mat-bond/BMI-EMG-HW/BioAmp/BioAmp-EXG-Pill.step

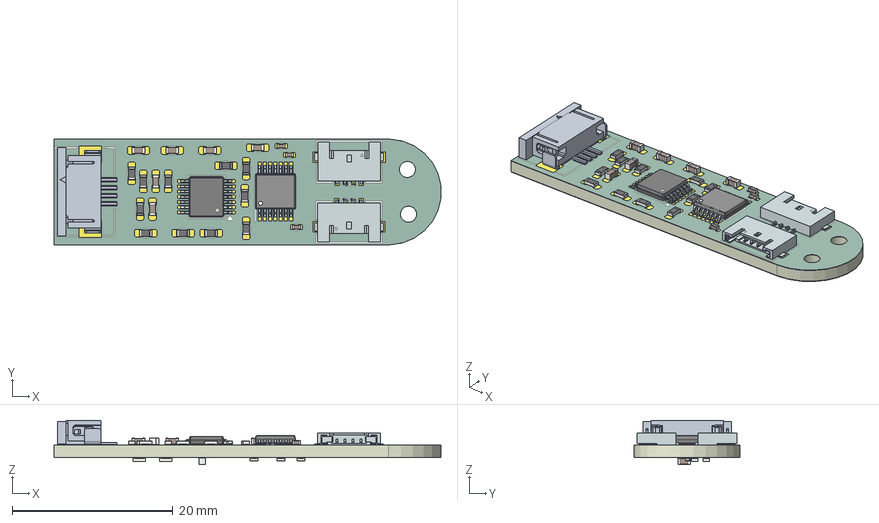
[picture p1: CAD file, 2026-10-02]
BioAmp/BioAmp-EXG-Pill.step
48.2 x 13.2 x 5.49 mm
R_0603_1608Metric x 15
C_0603_1608Metric x 7
TSSOP-14_4.4x5mm_P0.65mm
MAX5484EUD+
C_0402_1005Metric x 3
R_0402_1005Metric x 3
BioAmp-EXG-Pill-unsaved-export-KkKg1b_copper
BioAmp-EXG-Pill-unsaved-export-KkKg1b_silkscreen x 2
BioAmp-EXG-Pill-unsaved-export-KkKg1b_soldermask x 2
BioAmp-EXG-Pill-unsaved-export-KkKg1b_PCB
