mat-bond/BMI-EMG-HW/BioAmp/BioAmp-EXG-Pill.kicad_pcb

## KiCad design BioAmp/BioAmp-EXG-Pill.kicad_pcb (2026-10-08)

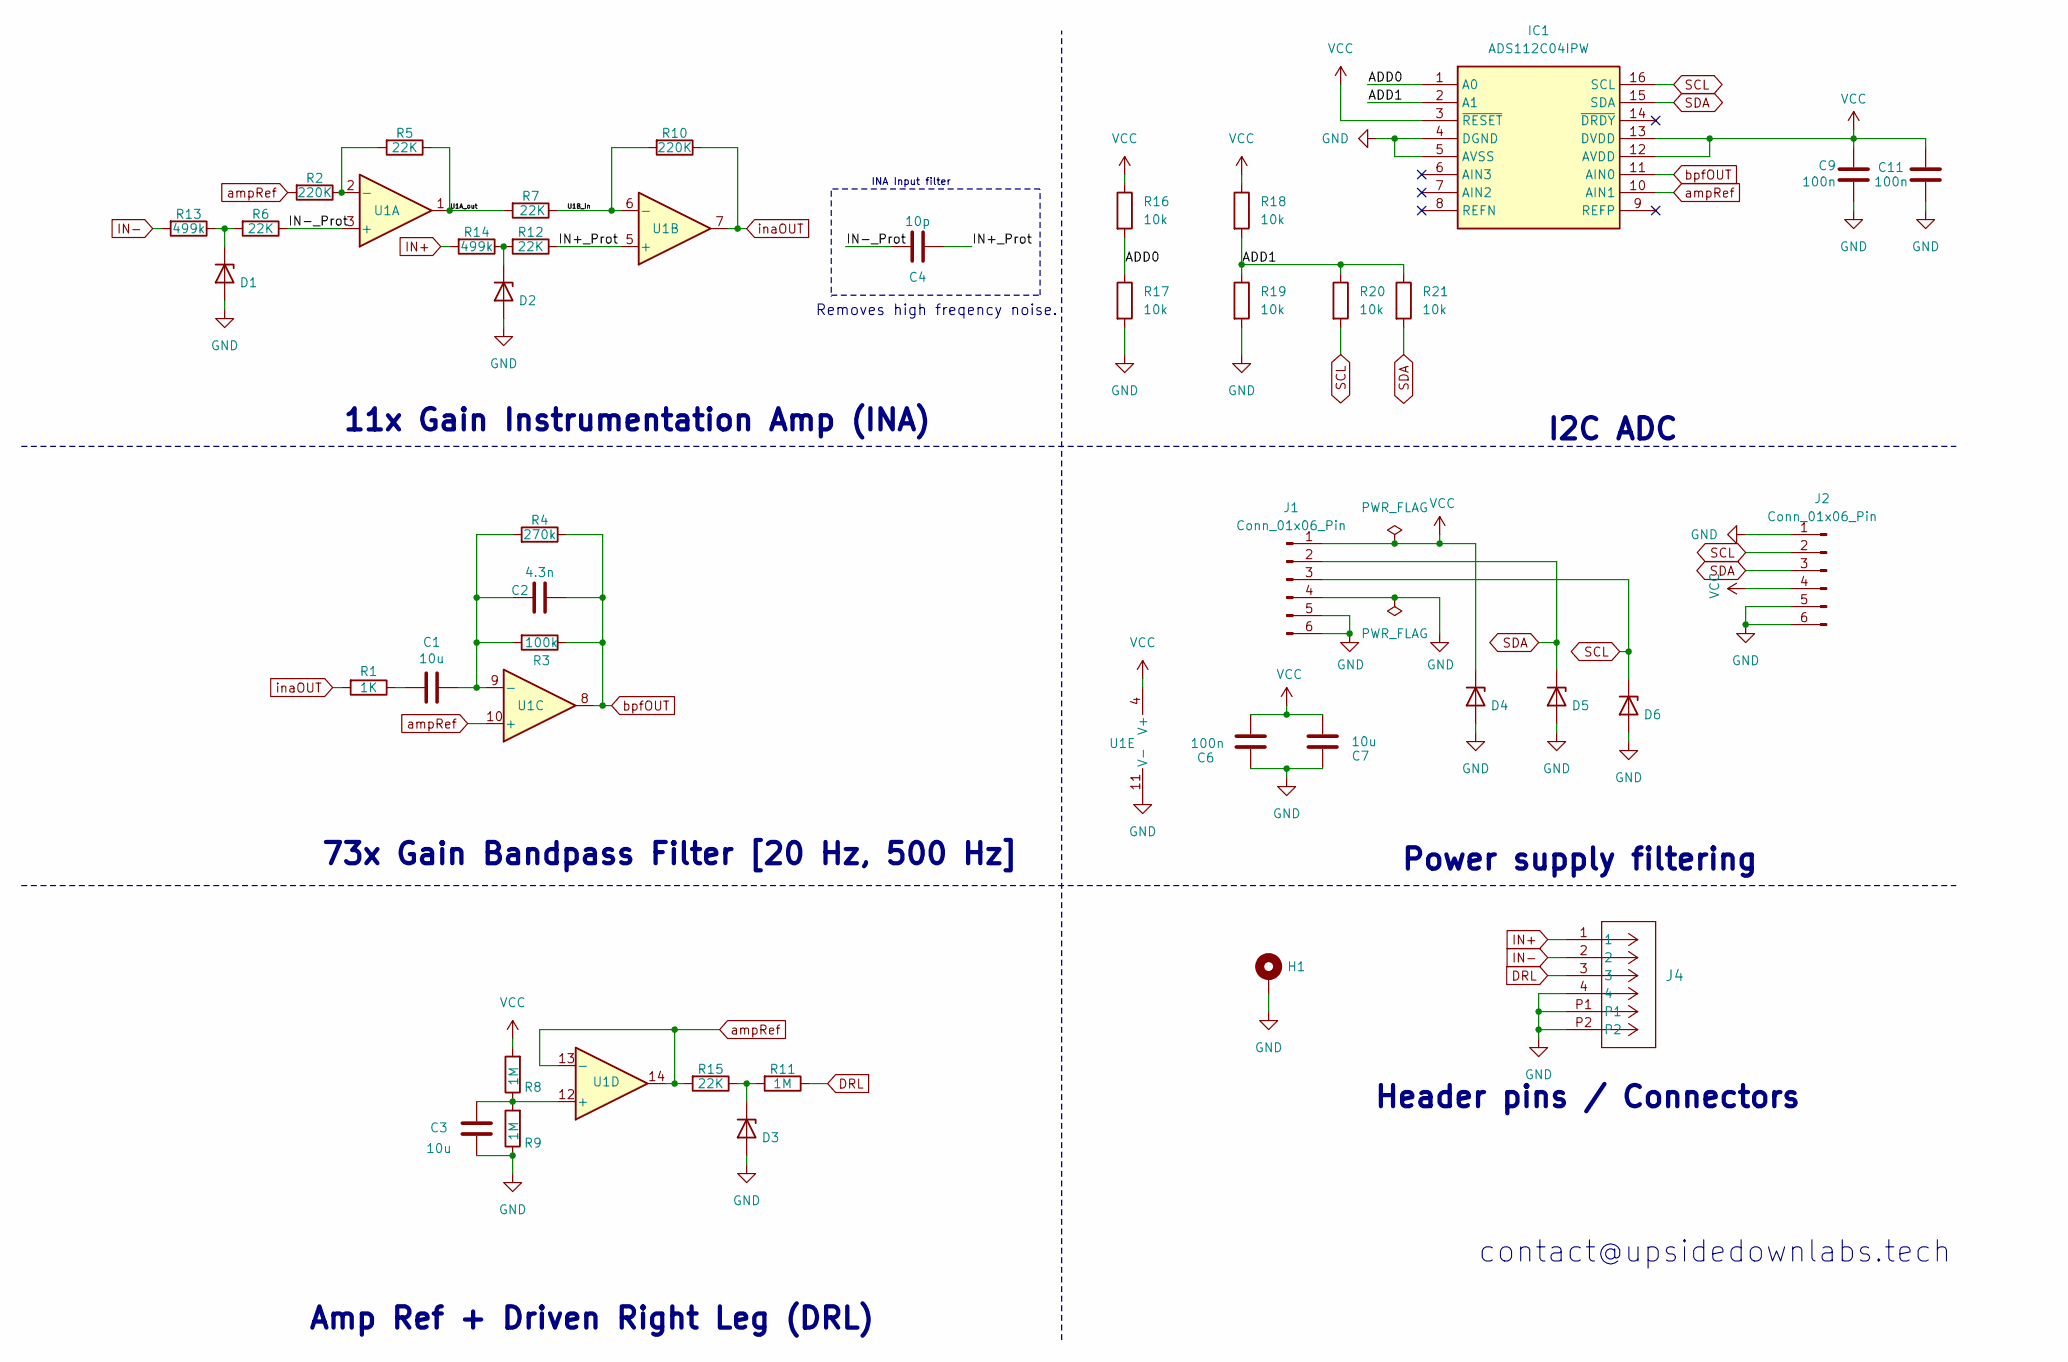
[picture p2: schematic BioAmp-EXG-Pill.kicad_sch, BioAmp EXG Pill]

Parts:
C1, C3, C7: 10u; C_0603_1608Metric_Pad1.08x0.95mm_HandSolder
C2: 4.3n; C_0603_1608Metric_Pad1.08x0.95mm_HandSolder
C4: 10p; C_0603_1608Metric_Pad1.08x0.95mm_HandSolder
C6: 100n; C_0603_1608Metric_Pad1.08x0.95mm_HandSolder
C9, C11: 100n; C_0402_1005Metric
D1, D2, D3, D4, D5, D6: ESD441DPLR; D_0201_0603Metric
H1: MountingHole_Pad; MountingHole_2.5mm_Pad
IC1: ADS112C04IPW; SOP65P640X120-16N; Mouser Part Number 595-ADS112C04IPW
J1, J2: Conn_01x06_Pin; CONN_5037630000-SD_04_MOL
J4: 522710469; CON_522710469_MOL
R1: 1K; R_0603_1608Metric_Pad0.98x0.95mm_HandSolder
R2, R10: 220K; R_0603_1608Metric_Pad0.98x0.95mm_HandSolder
R3: 100k; R_0603_1608Metric_Pad0.98x0.95mm_HandSolder
R4: 270k; R_0603_1608Metric_Pad0.98x0.95mm_HandSolder
R5, R6, R7, R12, R15: 22K; R_0603_1608Metric_Pad0.98x0.95mm_HandSolder
R8, R9, R11: 1M; R_0603_1608Metric_Pad0.98x0.95mm_HandSolder
R13, R14: 499k; R_0603_1608Metric_Pad0.98x0.95mm_HandSolder
R16, R17, R18, R19, R20, R21: 10k; R_0603_1608Metric_Pad0.98x0.95mm_HandSolder
U1: TL074HIPWR; TSSOP-14_4.4x5mm_P0.65mm

Connections:
/ADD0: IC1.1 (A0), R16.2, R17.1
/ADD1: IC1.2 (A1), R18.2, R19.1, R20.1, R21.1
/IN+_Prot: C4.1, R12.1, U1.5 (+)
/IN-_Prot: C4.2, R6.1, U1.3 (+)
/U1A_out: R5.1, R7.2, U1.1
/U1B_in: R7.1, R10.2, U1.6 (-)
DRL: J4.3, R11.1
GND: C3.2, C6.1, C7.1, C9.1, C11.1, D1.2 (A), D2.2 (A), D3.2 (A), D4.2 (A), D5.2 (A), D6.2 (A), H1.1 (1_1), IC1.4 (DGND), IC1.5 (AVSS), J1.4, J1.5, J1.6, J2.1, J2.5, J2.6, J4.4, J4.P1, J4.P2, R9.1, R17.2, R19.2, U1.11 (V-)
IN+: J4.1, R14.2
IN-: J4.2, R13.2
unnamed: C1.2, R1.1
unnamed: D1.1 (K), R6.2, R13.1
unnamed: D2.1 (K), R12.2, R14.1
unnamed: D3.1 (K), R11.2, R15.1
unnamed: R2.1, R5.2, U1.2 (-)
unnamed: C1.1, C2.2, R3.2, R4.2, U1.9 (-)
unnamed: C3.1, R8.1, R9.2, U1.12 (+)
SCL: D6.1 (K), IC1.16 (SCL), J1.3, J2.2, R20.2
SDA: D5.1 (K), IC1.15 (SDA), J1.2, J2.3, R21.2
VCC: C6.2, C7.2, C9.2, C11.2, D4.1 (K), IC1.3 (~RESET), IC1.12 (AVDD), IC1.13 (DVDD), J1.1, J2.4, R8.2, R16.1, R18.1, U1.4 (V+)
ampRef: IC1.10 (AIN1), R2.2, R15.2, U1.10 (+), U1.13 (-), U1.14
bpfOUT: C2.1, IC1.11 (AIN0), R3.1, R4.1, U1.8
inaOUT: R1.2, R10.1, U1.7

Notes on the sheet:
contact@upsidedownlabs.tech
73x Gain Bandpass Filter [20 Hz, 500 Hz]
Header pins / Connectors
11x Gain Instrumentation Amp (INA)
Power supply filtering
Amp Ref + Driven Right Leg (DRL)
Removes high freqency noise.
I2C ADC
INA Input filter

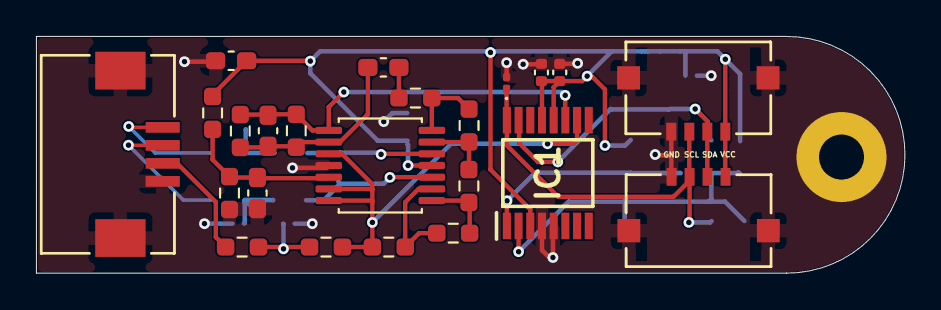
[picture p3: board BioAmp-EXG-Pill.kicad_pcb from above]

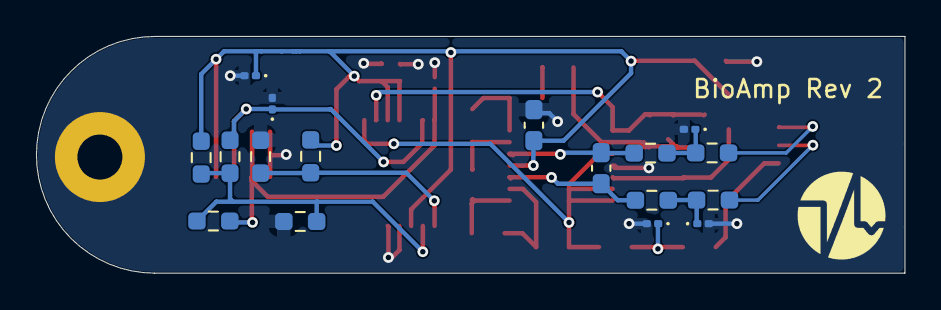
[picture p4: board BioAmp-EXG-Pill.kicad_pcb from below]

Board: 4 copper layers, 48.2 x 13.2 mm, 41 parts (17 on the bottom side), 23 nets.
