mat-bond/BMI-EMG-HW/(commit log)

2026-09-27 Changed bpf gain comment to x180 and added a .gitignore.
    [BioAmp-EXG-Pill.kicad_sch]
2026-09-27 Changed DRL R11 resistor to 1MegaOhm after improvement in signal quality after soldering one on.
    [BioAmp-EXG-Pill.kicad_sch]
2026-09-27 Added Do Not Place marking on C4.
    [BioAmp-EXG-Pill.kicad_sch]
2026-09-28 Changed bandpass gain to x73 and cutoff frequencies to 20 Hz and 500 Hz.
    [BioAmp-EXG-Pill.kicad_pcb, BioAmp-EXG-Pill.kicad_sch]
2026-09-28 Changed C4 to 10pF to increase impedance.
    [BioAmp-EXG-Pill.kicad_sch]
2026-09-28 Added TVS diodes
    [BioAmp-EXG-Pill.kicad_sch]
2026-09-28 Added series resistor after ESD protection at opamp input, 2.2kohm
    [BioAmp-EXG-Pill.kicad_sch]
2026-09-29 Added new ADC and cleaned up ESD protection
    [BioAmp-EXG-Pill.kicad_pcb, BioAmp-EXG-Pill.kicad_sch]
2026-09-29 Fixed ESD protection on J1 (connections were on the wrong side).
    [BioAmp-EXG-Pill.kicad_sch]
2026-09-29 Added series resitors on all electrode connection pins for current limiting
    [BioAmp-EXG-Pill.kicad_pcb, BioAmp-EXG-Pill.kicad_sch]
2026-09-30 Changed electrode resistances to one 1M
    [BioAmp-EXG-Pill.kicad_sch]
2026-09-30 Changed TVS diodes to have lower clamping voltage and added series resitors after protected nodes on opamp
    [BioAmp-EXG-Pill.kicad_pcb, BioAmp-EXG-Pill.kicad_sch]
2026-09-30 Changed IN+/IN- resistors to 500k to reduce noise. Refactored wiring that was off grid
    [BioAmp-EXG-Pill.kicad_sch]
2026-09-30 Added footprints and modesl
    [MAX1169BEUD+.stp]
2026-10-01 Changed C12 to 10uF as per ADC datasheet recommendation
    [BioAmp-EXG-Pill.kicad_sch]
2026-10-01 Removed licensed models
    [MAX1169BEUD+.stp]
2026-10-01 Added ESD diode footprints
    [BioAmp-EXG-Pill.kicad_pcb, BioAmp-EXG-Pill.kicad_sch]
2026-10-01 Exposed J1 4th pin to add a do-not-connect
    [BioAmp-EXG-Pill.kicad_sch]
2026-10-01 Added models and footprints
    [BioAmp-EXG-Pill.kicad_pcb, MAX1169BEUD+.stp]
2026-10-01 Updated FPC connector symbol and footprint
    [BioAmp-EXG-Pill.kicad_pcb, BioAmp-EXG-Pill.kicad_sch]
2026-10-01 Added board constraints
    [BioAmp-EXG-Pill.kicad_pcb, BioAmp-EXG-Pill.kicad_sch]
2026-10-02 Did component placement
    [BioAmp-EXG-Pill.kicad_pcb, BioAmp-EXG-Pill.kicad_sch]
2026-10-02 Added rounded edge with mounting hole
    [BioAmp-EXG-Pill.kicad_pcb, BioAmp-EXG-Pill.kicad_sch]
2026-10-02 Changed I2C connectors, added mounting holes and roundes edge
    [5037630491.stp, 522710469.stp, BioAmp-EXG-Pill.kicad_pcb, BioAmp-EXG-Pill.kicad_sch, BioAmp-EXG-Pill.step]
2026-10-03 Save BioAmp layout before splitting analog and digital grounds
    [BioAmp-EXG-Pill.kicad_pcb, BioAmp-EXG-Pill.kicad_sch]
2026-10-03 Separated analog and digital grounds in schematic
    [BioAmp-EXG-Pill.kicad_sch]
2026-10-03 Finished first layout with separated analog and digital grounds
    [BioAmp-EXG-Pill.kicad_pcb, BioAmp-EXG-Pill.kicad_sch]
2026-10-03 Changed to one mountign hole, improved TVS routing on SCL and SDA
    [BioAmp-EXG-Pill.kicad_pcb, BioAmp-EXG-Pill.kicad_sch]
2026-10-03 Moved C6 decoupling capacitor closer to opamp
    [BioAmp-EXG-Pill.kicad_pcb]
2026-10-03 Moved GND/GNDA tie up and placed vias closer to it.
    [BioAmp-EXG-Pill.kicad_pcb]
2026-10-03 Added silkscreen comments
    [BioAmp-EXG-Pill.kicad_pcb]
2026-10-04 Finished BOM
    [BioAmp-EXG-Pill.csv, BioAmp-EXG-Pill.kicad_pcb, BioAmp-EXG-Pill.kicad_sch]
2026-10-04 Moved R18 to bottom layer to have more space for connector mate
    [BioAmp-EXG-Pill.kicad_pcb, BioAmp-EXG-Pill.kicad_sch]
2026-10-04 Revert to one GND
    [BioAmp-EXG-Pill.kicad_pcb, BioAmp-EXG-Pill.kicad_sch]
2026-10-04 Changed copper pours to never add islands
    [BioAmp-EXG-Pill.kicad_pcb]
2026-10-06 Stopped tracking of footprints
    [5037630491.stp, 522710469.stp, BioAmp-EXG-Pill.csv, BioAmp-EXG-Pill.kicad_pcb, MAX1169BEUD+.stp]
2026-10-07 Changed schematics to new ADC ADS
    [BioAmp-EXG-Pill.kicad_pcb, BioAmp-EXG-Pill.kicad_sch]
2026-10-07 Added footprints
    [5037630491.stp, 522710469.stp, ADS112C04IPW.SchLib, ADS112C04IPW.stp, EDI2CAP.CFG, MAX1169BEUD+.stp, SOP65P640X120-16N.PcbLib, chips.prt]
2026-10-07 Finished layout with new ADC - ADS
    [BioAmp-EXG-Pill.kicad_pcb, BioAmp-EXG-Pill.kicad_sch]
2026-10-07 Changed position of TVS on SCL
    [BioAmp-EXG-Pill.kicad_pcb]
2026-10-07 Added via to GND pins on ADC
    [BioAmp-EXG-Pill.kicad_pcb]
2026-10-07 Moved SDA connection
    [BioAmp-EXG-Pill.kicad_pcb]
2026-10-07 Fixed D5 connection
    [BioAmp-EXG-Pill.kicad_pcb]
2026-10-07 Updated schematic to reduce hanging wire
    [BioAmp-EXG-Pill.kicad_sch]
2026-10-08 Moved bottom resistors away from edge
    [BioAmp-EXG-Pill.kicad_pcb]
2026-10-08 Changed jumper resistors to 0k and added do not populate flag
    [BioAmp-EXG-Pill.kicad_sch]
2026-10-09 Removed models
    [5037630491.stp, 522710469.stp, ADS112C04IPW.SchLib, ADS112C04IPW.stp, EDI2CAP.CFG, MAX1169BEUD+.stp, SOP65P640X120-16N.PcbLib, chips.prt]
